DeepSea-Developments/DSD-CTF/README.md

View this project on [CADLAB.io](https://cadlab.io/project/25183). 

# DSD-CTF
DeepSea's Capture the flag project
