DeepSea-Developments/DSD-CTF/(commit log)

2022-02-07 Esquematico del AVR CTF para revisión
    [AVR-CTF.kicad_pcb, AVR-CTF.kicad_sch]
2022-03-02 Cambio de kicad 6 a 5.1.12
    [AVR-CTF.kicad_pcb, AVR-CTF.kicad_sch, AVR-CTF.sch]
2022-03-07 Porting kicad 6 a 5, segunda parte
    [MCU.sch, MONITOR.sch, power_supply.sch]
2022-03-09 Esquematico para revision
    [AVR-CTF.sch, MCU.sch, MONITOR.sch, power_supply.sch]
2022-03-11 Regulador de voltaje adicional para el avr-ctf
    [MONITOR.sch, power_supply.sch]
2022-03-14 Anexo de otro FTDI y regulador de voltaje
    [AVR-CTF.sch, MONITOR.sch, power_supply.sch]
2022-03-18 Versión para revisión
    [MCU.sch, MONITOR.sch, power_supply.sch]
2022-03-23 Generacion de gerbers y boom agrupado
    [AVR-CTF-B_Cu.gbr, AVR-CTF-B_Mask.gbr, AVR-CTF-B_Paste.gbr, AVR-CTF-B_SilkS.gbr, AVR-CTF-Edge_Cuts.gbr, AVR-CTF-F_Cu.gbr, AVR-CTF-F_Mask.gbr, AVR-CTF-F_Paste.gbr]
2022-03-24 Correción de dimensiones
    [AVR-CTF-B_Cu.gbr, AVR-CTF-B_Mask.gbr, AVR-CTF-B_Paste.gbr, AVR-CTF-B_SilkS.gbr, AVR-CTF-Edge_Cuts.gbr, AVR-CTF-F_Cu.gbr, AVR-CTF-F_Mask.gbr, AVR-CTF-F_Paste.gbr]
2022-03-24 Correciones del retorno de tierra
    [AVR-CTF-B_Cu.gbr, AVR-CTF-B_Mask.gbr, AVR-CTF-B_Paste.gbr, AVR-CTF-B_SilkS.gbr, AVR-CTF-Edge_Cuts.gbr, AVR-CTF-F_Cu.gbr, AVR-CTF-F_Mask.gbr, AVR-CTF-F_Paste.gbr]
2022-06-05 Generacion .cache
    [MCU.sch]
2022-06-05 Generacion .cache 2
    [AVR-CTF.kicad_pcb, MCU.sch, MONITOR.sch, power_supply.sch]
